Nilles3D/showerCtrl/pics/20260515_212510.jpg

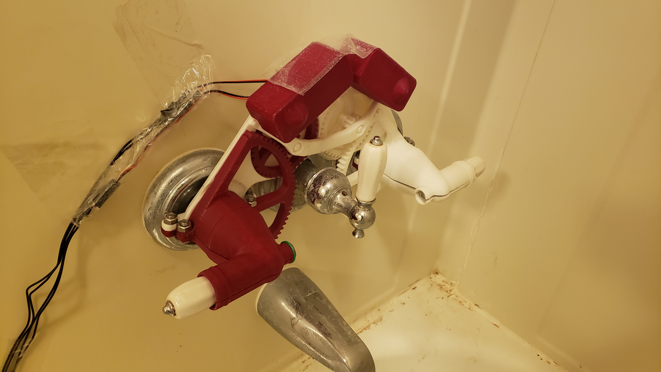
pics/20260515_212510.jpg
