Nilles3D/showerCtrl/pics/20260515_212531.jpg

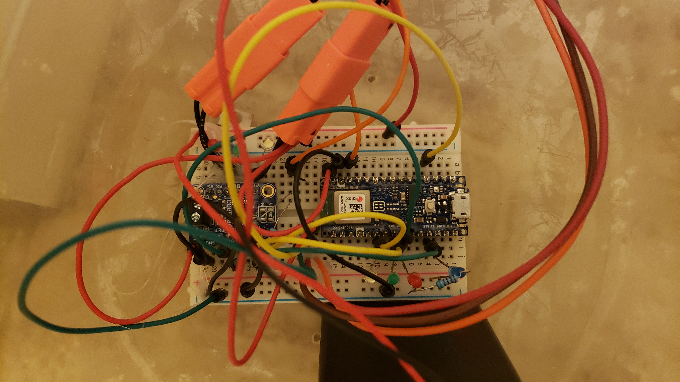
pics/20260515_212531.jpg
