Nilles3D/showerCtrl/README.md

CAD at:
https://cad.onshape.com/documents/ea0815881723a260ae0dbae3/w/9a7221d91bd3ae4148e53070/e/d74d81208dabf9a2e88ae707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
