Nilles3D/showerCtrl/pics/20260515_212517.jpg

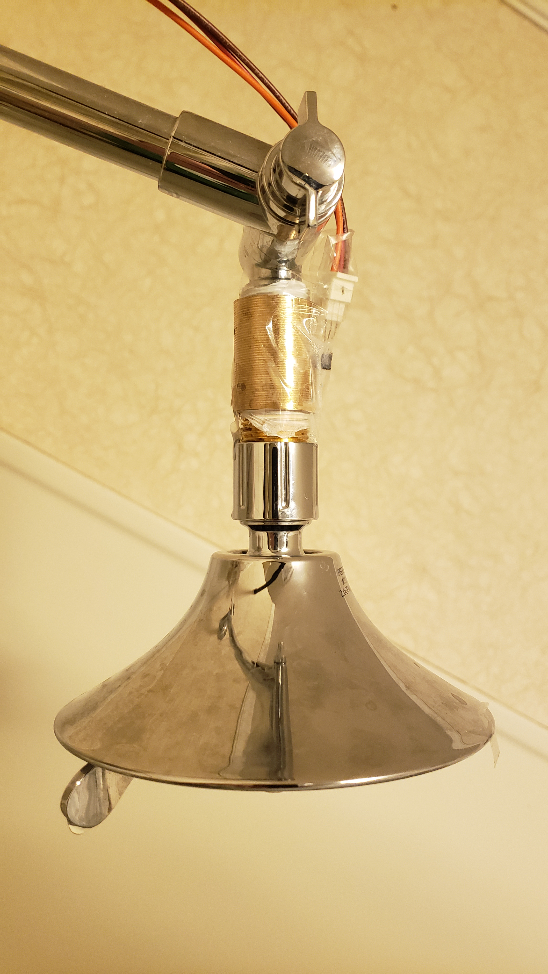
pics/20260515_212517.jpg
