Nilles3D/showerCtrl/test dTdR 15deg.txt

15 degree steps

Starting system...
  temperature = 2039 (20C)
Water temp set at 37

Using gear ratio 26.83
Full speed:
bit2spd given 255 bits produces 124 RPM
For basic motor full revolution check: 
ang2time given 360 degrees (1.00 revs) and 124 RPM (2.07 rps) makes 12983 milliseconds
For charting temperature per positoin increment: 
ang2time given 15 degrees (0.04 revs) and 255 RPM (4.25 rps) makes 263 milliseconds

Initial Motor H turn:
ang2time given 80 degrees (0.22 revs) and 124 RPM (2.07 rps) makes 2885 milliseconds

runMotor given motor 0, direction 255, and time 2885
 Ramp time approximated as 150
 H fwd
 motorH_log now 735675

Initial Motor C turn:
ang2time given 30 degrees (0.08 revs) and 124 RPM (2.07 rps) makes 1081 milliseconds

runMotor given motor 1, direction -255, and time 1081
 Ramp time approximated as 150
 C rev
 motorC_log now -275655

Waiting for predetermined time ... 

Setup done

While MOTOR_C is at -275655
  temperature = 2035 (20C)
  temperature = 2113 (21C)
  temperature = 2102 (21C)
  temperature = 2137 (21C)
  temperature = 2156 (21C)

runMotor given motor 1, direction -255, and time 263
 Ramp time approximated as 150
 C rev
 motorC_log now -342720
While MOTOR_C is at -342720
  temperature = 2204 (22C)
  temperature = 2343 (23C)
  temperature = 2432 (24C)
  temperature = 2356 (23C)
  temperature = 2507 (25C)

runMotor given motor 1, direction -255, and time 263
 Ramp time approximated as 150
 C rev
 motorC_log now -409785
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
 Ramp time approximated as 150
 H rev
 motorH_log now -255

runMotor given motor 0, direction -200, and time 60
 Ramp time approximated as 23
 H rev
 motorH_log now -12255

runMotor given motor 1, direction 255, and time 235
 Ramp time approximated as 150
 C fwd
 motorC_log now 119595
